tohoku-tomailab/saigen/README.md

# SAIGEN

**SAIGEN** — **S**tandardized **A**utomation **I**nfrastructure for **G**eneralizable
**E**xperiment reproductio**N** (also *saigen*, 再現, Japanese for "reproduction").

A simple, easy-to-introduce, open-source platform for automated materials-synthesis
experiments, focusing on **reliable automation and quantitative process recording**
rather than full autonomy.

Repository: https://github.com/tohoku-tomailab/saigen
(QR code for slides and posters: [`docs/images/qr-saigen.png`](docs/images/qr-saigen.png),
[`docs/images/qr-saigen.svg`](docs/images/qr-saigen.svg))

A paper describing the platform and its ZIF-8 demonstration has been accepted for
publication in *Science and Technology of Advanced Materials: Methods* (STAM Methods)
and is in press (working title: *Quantitative control and improved reproducibility of
materials synthesis processes using an automated experimentation platform*). It is
referred to as "the paper" throughout this repository; see [Citing](#citing).
<!-- TODO: on publication, replace the working title with the published one and add
     the volume and article number, here, under "Citing" and in CITATION.cff. -->

The platform combines commercially available instruments (robot arms, electric
pipettes, web cameras, an electronic balance) with 3D-printed fixtures, and operates
them with control code generated by an AI agent based on a large language model (LLM).
As a demonstration, ZIF-8 (a metal–organic framework) was synthesized with a
two-solution mixing system, and the dependence of its particle size distribution on
the solution dispensing speed was quantified and reproduced.

**Video:** the two-solution mixing system built on this platform, in operation:
https://youtu.be/5X2-4LuQfns

## Repository layout

The repository's main resources are organized into five parts:

| Part | Folder |
|---|---|
| Control code for the instruments | [`src/`](src/) |
| Fixture design data (CAD design bank) | [`cad/`](cad/) |
| Procedures for setting up and modifying the system | [`docs/`](docs/) |
| Knowledge base: what bringing each instrument into the cell taught us | [`knowledge/`](knowledge/) |
| Example experiments | [`examples/`](examples/) |

Beside these, `tests/` and `.github/` hold the automated tests and their CI, and
`detection/` is an optional object-detection module kept apart for licensing
reasons (see below). In detail:

| Path | Contents |
|---|---|
| `src/agent/` | AI agent that generates JSON experimental flows from natural language (Gemini API or any OpenAI-compatible endpoint) and the preset flows |
| `src/devices/` | Control drivers for each instrument (robot arm, electric pipette, hot-plate stirrer, electronic balance, webcam, digital microscope, and the optional Hiwonder MaxArm suction arm) and the safety wrapper the flows run through |
| `src/flow/` | Schema, validator, executor and command-line runner for the JSON experimental flow format |
| `src/gui/` | Browser-based GUI for parameter input and flow confirmation |
| `src/voice/` | Voice input (whisper-large-v3-turbo) |
| `src/monitoring/` | IoT sensor logging (Raspberry Pi + Environment Sensor HAT) and process cameras |
| `src/imaging/` | Appearance-imaging system: NEEWER RGB62 light + Logitech C920n camera control, white/red/green/blue capture sequence, cropped-image comparison and depth-direction transmitted-light profiles (paper Figure 6) |
| `detection/` | Object detection based on YOLOv8 — **kept separate for licensing reasons, see below** |
| `cad/` | CAD design bank of 3D-printable experimental components (STL + editable Fusion 360 sources) |
| `docs/` | Procedures: bill of materials, setup guide, experimental-flow format reference, spreadsheet-input guide, guide to adding an instrument |
| `knowledge/` | Knowledge base: what bringing each instrument into the cell taught us (order of work, replies that differed from the manual, defects found, open points). Index in [`knowledge/README.md`](knowledge/README.md) |
| `examples/zif8/` | Sample experimental flows of the ZIF-8 demonstration (JSON equivalents of the spreadsheet sequence) and monitoring CSV templates |
| `examples/microscope/` | Example flow that photographs the product with the USB digital microscope (`capture_microscope`) |
| `examples/maxarm/` | Example suction pick-and-place flow for the optional Hiwonder MaxArm (robot 4) |
| `examples/mg400/` | Example flow and complete `config.yaml` for the optional Dobot MG400 (robot 5, TCP/IP) |
| `examples/dispensing_stability/` | Measured data of the 100-shot dispensing-repeatability test and the script that recorded it |

## Getting started

1. See [`docs/bom.md`](docs/bom.md) for the full list of hardware used.
2. Print the fixtures in `cad/` (STL files; the Fusion 360 sources are included for
   modification — see [`cad/README.md`](cad/README.md)).
3. Follow [`docs/setup.md`](docs/setup.md) to connect the instruments to the control PC.
4. Copy `config.example.yaml` to `config.yaml` and set the COM ports and workspace
   limits of your own cell; copy `.env.example` to `.env` and set your API keys.
   **Never commit `.env` or `config.yaml`.**
5. Install the Python dependencies: `pip install -r requirements.txt`
   (module-specific notes, e.g. for the imaging system, are in each `src/<module>/README.md`).
   Check the installation with `pytest tests/` — the suite needs no hardware.
6. After every power-on, home each arm once so the firmware's joint angles match the
   real arm (`python -m src.devices.dobot.home_dobot --robot 1 --mock` to rehearse,
   then without `--mock`; the arm sweeps to its joint-1 end stop, so clear the area).
   Then dry-run a flow without hardware, then run it for real. The ZIF-8 examples are the
   JSON equivalents of the spreadsheet sequence in step 7, which is the path the
   paper's batches were actually run with:

   ```bash
   python -m src.flow.run_flow examples/zif8/zif8_two_solution_mixing_speed5.json --mock
   python -m src.flow.run_flow examples/zif8/zif8_two_solution_mixing_speed5.json
   ```

   Every move is checked against the `workspace` limits in `config.yaml` before the
   robot is commanded — in `--mock` mode too. Ctrl+C is an emergency stop: the arm
   halts where it is rather than driving home (an MG400 is the exception: its Ctrl+C
   starts an orderly stop, a second Ctrl+C waits for it to finish, and its emergency
   stop is the button on its controller,
   `docs/setup.md` §13). Each run leaves
   `logs/<date>/<flow>_<time>/` with `run.log`, `measurements.csv`, `summary.md`,
   `metadata.json` and a copy of the flow; add `--no-record` to skip the sensor-CSV
   and video recording that real runs start by default.

7. Or set the parameters in a spreadsheet — **this is the path used for the paper's
   ZIF-8 experiments**: the two-solution mixing experiment (shown in the
   [video](https://youtu.be/5X2-4LuQfns) above) runs from a
   `parameter,value,note` CSV, with no JSON at all:

   ```bash
   cp src/flow/csv_runner/control.example.csv src/flow/csv_runner/control.csv
   python -m src.flow.csv_runner.run_csv --mock   # then without --mock for a real run
   ```

   The sheet is range-checked before any device is opened, the generated steps go
   through the same schema and workspace validator as a JSON flow, and the run leaves
   the same log folder; see [`docs/csv-runner.md`](docs/csv-runner.md).

8. Or use the GUI, where flows can also be generated from natural language or voice
   (the reported ZIF-8 batches did not use this path):

   ```bash
   streamlit run src/gui/app.py
   ```

   Ports come from `config.yaml` and stay editable in the sidebar; the flow is
   validated against the same schema before any device is opened, *Mock* runs it
   end to end without hardware, *Stop* aborts through the same emergency-stop path
   as Ctrl+C, and the run leaves the same `logs/<date>/…` folder as the CLI.

## Using SAIGEN with an AI coding agent

The intended way to adopt SAIGEN is to clone (or download) the repository, open it
in an AI coding agent such as Claude Code, Codex or Cursor, and let the agent adapt
it to your hardware in conversation. [`CLAUDE.md`](CLAUDE.md) (identical to
[`AGENTS.md`](AGENTS.md)) tells the agent how the repository is organised, how to
verify changes without hardware, and what it must not do on its own — in particular,
it must never start a real run or loosen the workspace limits without you asking.
A first message that works well:

> Read CLAUDE.md, then help me adapt this platform to my hardware: one Dobot Magician
> on COM3 with a Picus 2 pipette on COM4, a BCE8221 balance on COM8 and no second robot.
> Validate and mock-run an example flow when you are done.

Everything the agent does is also available by hand through the steps above.

The flow format is described in [`docs/experimental-flow.md`](docs/experimental-flow.md),
the spreadsheet input in [`docs/csv-runner.md`](docs/csv-runner.md), and adding an
instrument to the platform in [`docs/adding-an-instrument.md`](docs/adding-an-instrument.md); the ZIF-8 flows —
JSON equivalents of the spreadsheet sequence the paper's batches were run with — are in
[`examples/zif8/`](examples/zif8/).

## Licensing

- **Code** (`src/`, `examples/`): MIT License — see [`LICENSE`](LICENSE). Third-party components are listed in [`THIRD_PARTY_NOTICES.md`](THIRD_PARTY_NOTICES.md).
  The robot-arm driver uses [pydobot](https://github.com/luismesas/pydobot)
  (Copyright 2017 Luis Mesas, MIT License) with a small patch in
  `src/devices/dobot/pydobot_patch.py`. The vendor SDK (DobotDll) is **not** used and
  is not included in this repository.
- **CAD models and documentation** (`cad/`, `docs/`, `knowledge/`): Creative Commons Attribution 4.0
  (CC BY 4.0, https://creativecommons.org/licenses/by/4.0/); the CAD-specific notes are in
  [`cad/README.md`](cad/README.md).
- **Object detection** (`detection/`): depends on [Ultralytics YOLOv8](https://github.com/ultralytics/ultralytics),
  which is licensed under **AGPL-3.0**. This module is therefore isolated from the
  MIT-licensed code and is distributed under AGPL-3.0. The rest of the platform runs
  without it (object detection is an optional monitoring feature).

The fine-tuned YOLOv8 weights and the training images are **not** included in this
repository. `detection/README.md` describes how to fine-tune your own model for your
setup.

## Disclaimer

SAIGEN is research software, shared so that others can reproduce and build on our
work. It is provided "as is", without warranty of any kind; the full terms are in
[`LICENSE`](LICENSE) for the code and in Section 5 of CC BY 4.0 for the CAD models and
documentation. The authors and their institutions accept no liability for injury,
damage to equipment, loss of samples or data, or any other loss arising from its use.

- **It moves hardware and handles chemicals.** A real run drives robot arms, dispenses
  liquids and may heat and stir them. Anyone running it is responsible for their own
  risk assessment, for following the safety rules of their institution and the safety
  data sheets of their reagents, and for supervising the cell while it operates.
- **The safety layer is not a certified safety system.** The workspace validators and
  the emergency stop reduce the chance of a collision inside the limits *you*
  configure. They are not a substitute for guarding, a hardware emergency stop or
  the manufacturers' instructions, and they know nothing about what is actually on
  the bench. Measure your own cell, set your own limits, and always do a mock run
  and a supervised dry run before using reagents.
- **Review generated flows and code.** Flows drafted by the LLM agent, and changes
  made by an AI coding agent, can be wrong in ways that validation does not catch
  (a wrong volume, vial or temperature is still a valid flow). Read them before a
  real run.
- **The CAD models are untested outside our laboratory.** They were designed for our
  instruments and printers; strength, fit, heat resistance and chemical resistance
  depend on your material and print settings and are not guaranteed.
- **No affiliation.** SAIGEN is not affiliated with, endorsed by or supported by the
  manufacturers of the instruments it controls. Product names are trademarks of their
  respective owners. Using this software may fall outside an instrument's intended use
  and may affect its warranty; check with the manufacturer.

## Citing

If you use SAIGEN, please cite the paper:

> Y. Hashimoto, T. Muramoto, H. Terada, H. Song, Y. Wang, T. Tomai,
> *Science and Technology of Advanced Materials: Methods*, in press (2026).
> https://doi.org/10.1080/27660400.2026.2756911

The DOI becomes active when the paper is published. The software itself can be cited
with the metadata in [`CITATION.cff`](CITATION.cff) (GitHub's "Cite this repository"
button, which offers the paper as the preferred citation).
