tohoku-tomailab/saigen/docs/images/qr-saigen.png

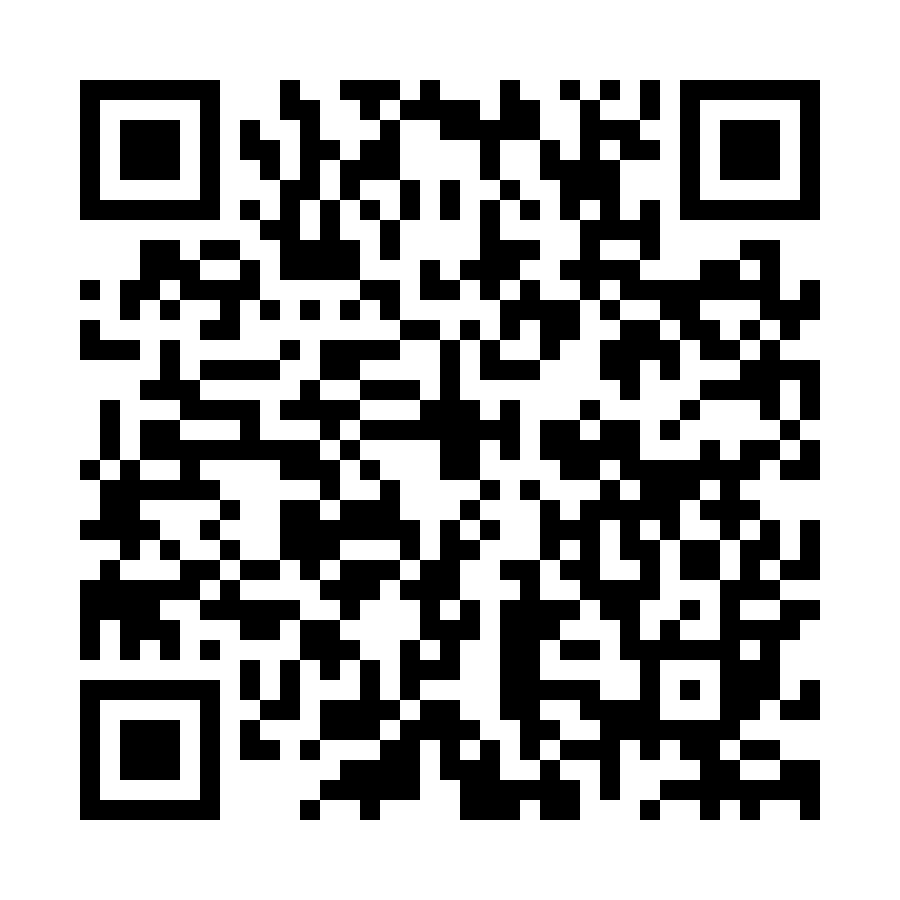
docs/images/qr-saigen.png
