tohoku-tomailab/saigen/cad/pipette-holder/picus2/picus2_holder_tall.step

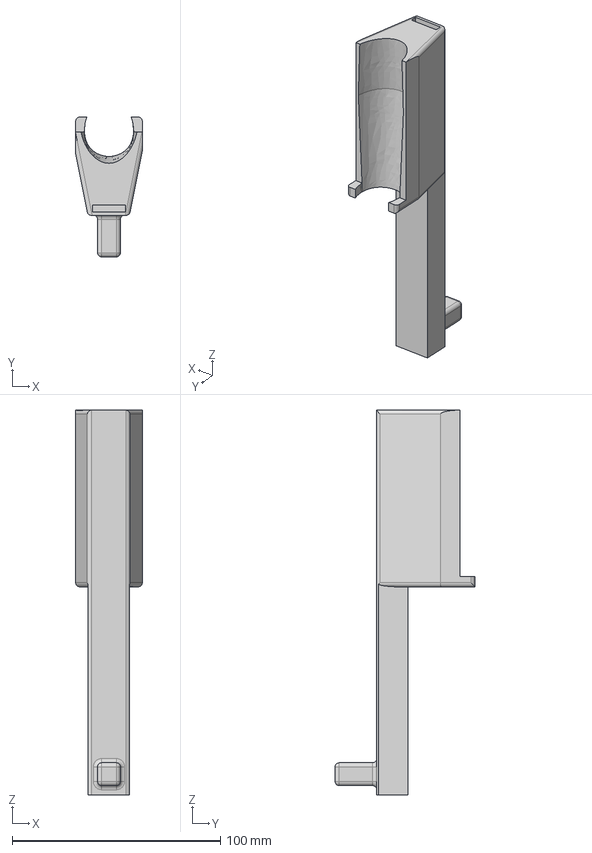
[picture p6: CAD file, 2026-11-02]
cad/pipette-holder/picus2/picus2_holder_tall.step
32.0 x 67.2 x 185.0 mm
