tohoku-tomailab/saigen/cad/pipette-holder/picus2/picus2_holder_short.step

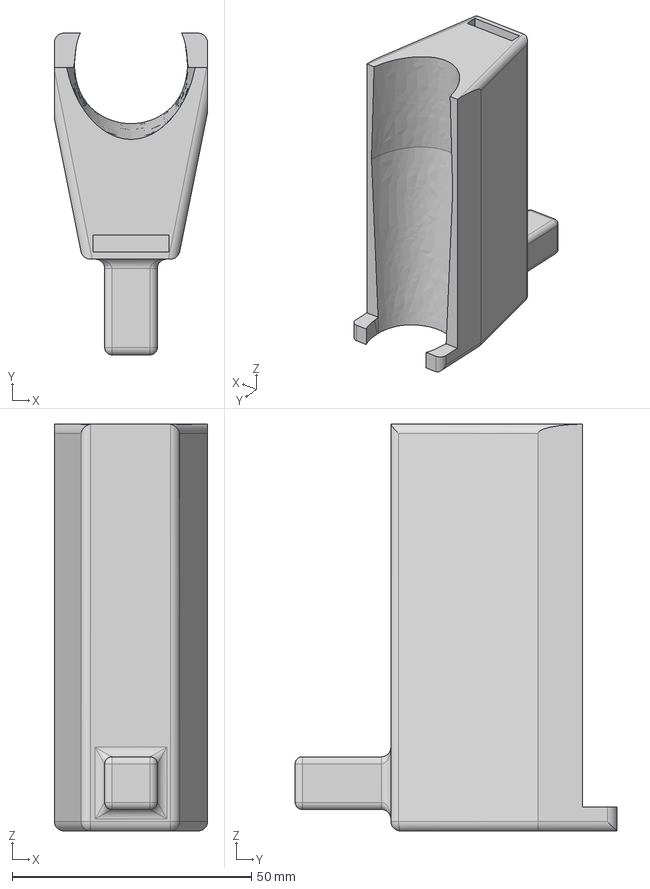
[picture p7: CAD file, 2026-11-02]
cad/pipette-holder/picus2/picus2_holder_short.step
32.0 x 67.2 x 85.0 mm
