tohoku-tomailab/saigen/cad/pipette-holder/picus2/picus2_holder_middle.step

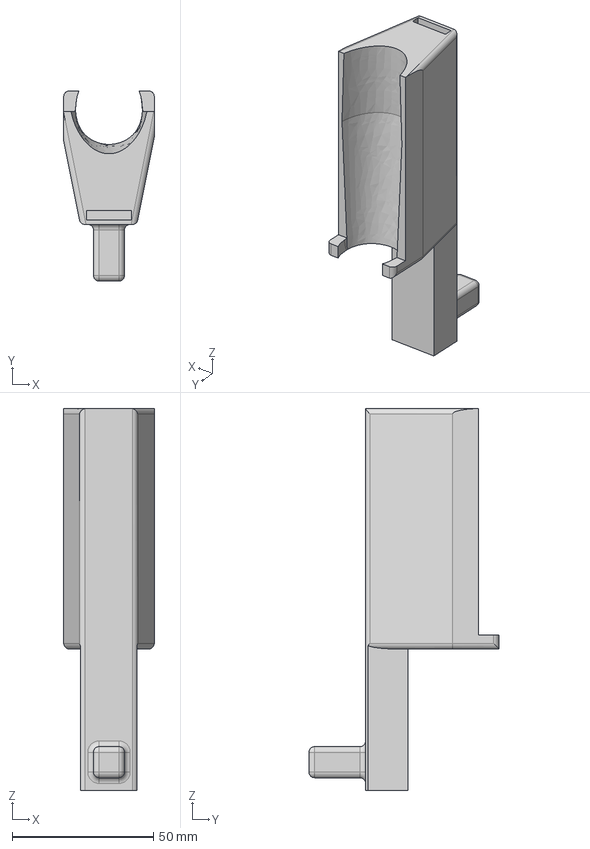
[picture p8: CAD file, 2026-11-02]
cad/pipette-holder/picus2/picus2_holder_middle.step
32.0 x 67.2 x 135.0 mm
