tohoku-tomailab/saigen/cad/pipette-holder/picus2/picus2_holder_3_middle.step

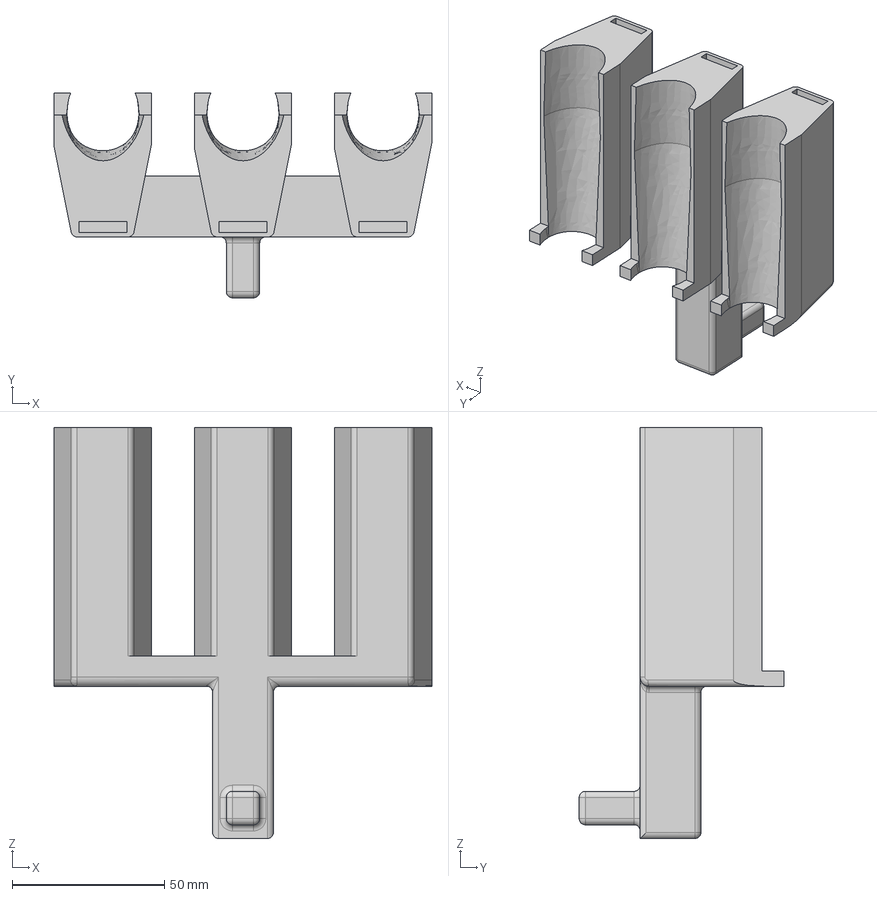
[picture p9: CAD file, 2026-11-02]
cad/pipette-holder/picus2/picus2_holder_3_middle.step
124.0 x 67.2 x 135.0 mm
