tohoku-tomailab/saigen/(list of files, cad)

Other CAD files:
cad/pipette-holder/picus2/picus2_holder_3_middle.f3d
cad/pipette-holder/picus2/picus2_holder_3_middle.stl
cad/pipette-holder/picus2/picus2_holder_middle.f3d
cad/pipette-holder/picus2/picus2_holder_middle.stl
cad/pipette-holder/picus2/picus2_holder_short.f3d
cad/pipette-holder/picus2/picus2_holder_short.stl
cad/pipette-holder/picus2/picus2_holder_tall.f3d
cad/pipette-holder/picus2/picus2_holder_tall.stl
