tohoku-tomailab/saigen/docs/experimental-flow.md

# Experimental flow format

The AI agent outputs experimental procedures as a JSON "experimental flow" — an
intermediate representation connecting the natural-language experimental objective
with the control code actually executed. Constraining the LLM output to structured
JSON suppresses generation variability and enables mechanical validation before
execution.

The schema is defined with Pydantic in [`src/flow/schema.py`](../src/flow/schema.py)
and executed by [`src/flow/executor.py`](../src/flow/executor.py). Run
`python src/flow/schema.py` to print the machine-readable JSON Schema.

## Top level

```json
{
  "name": "human-readable name",
  "description": "what the flow does",
  "steps": [ { "action": "...", ... }, ... ]
}
```

| Field | Type | Required | Notes |
|---|---|---|---|
| `name` | string | yes | |
| `description` | string | no | default `""` |
| `steps` | array | yes | executed in order; each element is one of the actions below |

Every step has an `action` field. Robot actions take `robot_id` (1–5, default 1);
shared-device actions (balance, camera) do not. Unknown fields (e.g. a misspelled
`robotid`), out-of-range values and non-finite numbers (`NaN`, `Infinity`) are
rejected at validation time.

### Robot types

Each robot in `config.yaml` has a `type`. Robots 1–3 are Dobot Magicians
(`type: dobot`, the default when the entry has no `type`, so existing
`config.yaml` files keep working). Robot 4 is an optional Hiwonder MaxArm
(`type: maxarm`) with a suction nozzle and no pipette. Robot 5 is an optional
Dobot MG400 (`type: mg400`) over TCP/IP, with neither. The type decides which
robot actions a robot accepts:

| Type | Accepted robot actions |
|---|---|
| `dobot` | `move_xyz`, `move_z`, `move_radial`, `rotate`, `rotate_relative`, `go_home`, `move_slider`, `move_conveyer`, `wait`, `aspirate`, `dispense`, `blow_out` |
| `maxarm` | `move_xyz`, `move_z`, `go_home`, `suction`, `wait` |
| `mg400` | `move_xyz`, `move_z`, `go_home`, `wait` |

The preflight rejects an action the robot's type does not accept (for example
`aspirate` on the MaxArm, or `suction` on a Dobot) before any device is opened,
exactly like a workspace violation (exit code 3 / `PreflightError`). The
executor refuses the same actions at run time as a second line of defence.

A robot can have its own `workspace` block under `robots.<id>` in
`config.yaml`. For a Dobot it is merged over the global `workspace` for that
robot only. A MaxArm (`type: maxarm`, at any robot id) or an MG400 (`type:
mg400`) **must** have one, and it is used on its own, never merged over the
global Dobot box (the frames differ):
`x_min` … `z_max` are all required, `r_min` / `r_max` (bounds on the horizontal
radius `hypot(x, y)`) are optional. A missing or incomplete MaxArm block, or any
workspace key left without a value (null), stops `--validate-only`, `--mock` and
real runs with a configuration error naming the robot, before any device is
opened. For the MaxArm the validator additionally runs the arm's own inverse
kinematics on the PC (`src/devices/maxarm/kinematics.py`): a `move_xyz` target
inside the box can still be unreachable (the wrist joint would leave 0..240°,
which happens near the top of the workspace), and such a step is rejected at
`--validate-only` with the highest reachable z at that (x, y). See
`docs/setup.md` §9. An MG400 entry must also set `home_position`,
`joint_limits`, `speed_ratio` and `max_move_mm` (nothing is inherited); its
`home_position` is checked against its box at `--validate-only`, and each move
is checked at run time against the box, the segment's radius and the
controller's inverse kinematics (`docs/setup.md` §13).

## Actions

### Robot arm (Dobot Magician) — `robot_id` required

| `action` | Parameters | Description |
|---|---|---|
| `move_xyz` | `x`, `y`, `z` (mm) | Absolute move in the arm's Cartesian frame |
| `move_z` | `distance` (mm) | Relative vertical move; positive = up |
| `move_radial` | `distance` (mm) | Relative move along the radius from the base; positive = outward |
| `rotate` | `angle` (deg) | Absolute base (joint 1) rotation |
| `rotate_relative` | `angle` (deg), `speed` (`"low"`/`"normal"`/`"high"`, default `"low"`) | Relative base rotation; positive = counter-clockwise seen from above (toward +Y) |
| `go_home` | — | Return to the home position captured at start-up |
| `move_slider` | `position` (0–1000 mm) | Linear rail (optional accessory) |
| `move_conveyer` | `index` (0/1), `speed` (0–200 mm/s), `duration` (0–300 s) | Conveyor belt (optional accessory) |

### Electric pipette (Sartorius Picus 2) — `robot_id` required

| `action` | Parameters | Description |
|---|---|---|
| `aspirate` | `volume` (0.5 ≤ v ≤ 10 mL), `speed` (1–9, default 5) | Aspirate; the wrapper refuses to exceed 10 mL total |
| `dispense` | `volume` (0.5 ≤ v ≤ 10 mL), `speed` (1–9, default 5) | Dispense; refuses to exceed the held volume |
| `blow_out` | `go_home` (bool, default true), `speed` (1–9, default 1), `delay_ms` (int, default 3000) | Expel residual liquid |

Speed 1 is slowest, 9 fastest (about 1–11 mL/s for a 10 mL tip, from the manufacturer's timing table).
The lower bound of 0.5 mL is the real wrapper's minimum operating volume
(`LabRobot.min_pipette_volume`); the schema enforces it so that a flow the mock
accepts is not rejected on hardware.

### Suction nozzle (Hiwonder MaxArm) — `robot_id` of a `maxarm` robot

| `action` | Parameters | Description |
|---|---|---|
| `suction` | `on` (bool, default true) | `true` switches the pump on (the object is held); `false` releases it (the firmware opens the release valve for about 1 s, so wait before lifting). Only a robot with `type: maxarm` accepts it |

MaxArm coordinates are in the arm's own frame (mm, origin on the base yaw axis,
z = 0 at the base plane, the arm faces −y at home); `move_xyz` / `move_z` /
`go_home` behave as on the Dobot. After an error the session stops the MaxArm
where it is and does **not** send it home (it has no verified safe return path);
the Dobots are still sent home as before. See
[`examples/maxarm/pick_and_place.json`](../examples/maxarm/pick_and_place.json).

### Dobot MG400 — `robot_id` of an `mg400` robot

An MG400 (`type: mg400`, robot 5 in the examples) accepts `move_xyz`, `move_z`,
`go_home` and `wait` only. Coordinates are the controller's base frame (mm, the
flange position as `PositiveSolution` reports it, User 0 / Tool 0); every move
keeps the R measured when the arm was connected. Every move is one straight `MovL` of at least
1 mm and at most `max_move_mm` (≤ 50 mm), checked before it is sent against
the robot's own box, the horizontal radius of the whole segment and the
controller's `InverseSolution` sampled every 5 mm within `joint_limits`
(`docs/setup.md` §13 lists the six steps). `go_home` goes to the configured
`home_position` and sends nothing when the arm is already within 1 mm of it.
After an error the session does not send an MG400 home; the stop sequence tries to
disable it where it stands, and the device report (`robot_reports`) says whether the
arm confirmed that. A real run asks the human for Enter on the terminal (or the GUI's
confirmation dialog) before any device is opened. The example is
[`examples/mg400/z_hop.json`](../examples/mg400/z_hop.json).

### Shared devices — no `robot_id`

| `action` | Parameters | Description |
|---|---|---|
| `tare_scale` | `delay` (0.1–10 s, default 1.0) | Tare the electronic balance |
| `measure_weight` | `stabilization_count` (1–10, default 3) | Read the balance; median of N readings, logged in grams |
| `capture_and_save` | `file_path` (string, `""` = auto-generate) | Capture a webcam image. If no image is saved the step fails (and the run stops) rather than being recorded as `ok`; the same holds for `capture_microscope` |
| `capture_microscope` | `file_path` (string, `""` = auto-generate) | Capture an image with the USB digital microscope (UVC, e.g. Sanwa Supply 400-CAM106); saved into the run's `images/` folder with `_microscope` in the name. Opens only the microscope camera; `microscope_led` opens only its serial port; `microscope_focus` opens both |
| `microscope_led` | `on` (bool, default true), `level` (0–255, optional) | Switch the microscope's LED ring on or off and optionally set its brightness (factory level 12). Needs `microscope_port` in `config.yaml` (the UM22's CP210x serial port) |
| `measure_dmm` | `function` (`dc_voltage`, `ac_voltage`, `dc_current`, `ac_current`, `resistance_2w`, `resistance_4w`; default `dc_voltage`), `samples` (1–10, default 3), `nplc` (0.01–50, default 1), `range` (optional fixed range in V, A or Ohm; omitted = autorange) | Measure with the Keithley 2002 DMM over GPIB; median of the valid samples (overflow readings are discarded). Writes `dmm_value` (full precision), `dmm_unit`, `dmm_function`, the `dmm_range` and `dmm_nplc` read back from the instrument after the last sample (on autorange: the range the last sample used) and `dmm_valid_samples` to `measurements.csv`. Each step starts from `:CONFigure:<function>` (single-shot trigger model; math, buffer and scanning off; acquisition method normal; autozero and the function's own settings such as filter and REL back to their `*RST` values), so those front-panel settings do not change the result. Settings outside that list, such as line synchronization, are left alone; the line-sync state is written to `run.log` when the DMM is opened. Needs `dmm_resource` in `config.yaml` (e.g. `GPIB0::16::INSTR`). A flow of DMM steps only opens no robot |
| `measure_lockin` | `samples` (1–100, default 5), `interval` (0–60 s between readings, default 0) | Read the NF LI5640 lock-in amplifier over GPIB (read-only: its measurement settings stay on the front panel; only the read-out selection `OTYP` is written and restored). Median of the valid readings of DATA1 and DATA2 (as displayed: X, R, θ, noise or AUX; θ on the narrowest arc, the step fails if the phases spread over 180° or more) and of the measured reference frequency. Readings with an over-level or UNLOCK are discarded and counted. Writes `lockin_data1` / `lockin_data2` (full precision) with `_kind` (e.g. `X`, `THETA`, `X[dB]`, `Y[ratio]`) and `_unit`, `lockin_freq`, `lockin_sensitivity`, `lockin_time_constant`, `lockin_valid_samples`, `lockin_invalid` and the panel settings (`lockin_settings`, JSON) to `measurements.csv`. The step fails if a panel setting differs before and after the readings; the settings and the difference then go to the `diagnostics` column and `metadata.json`. It does not wait for the output to settle. Needs `lockin_resource` in `config.yaml`. A flow of lock-in steps only opens no robot |
| `measure_scope` | `channel` (1–4, default 1; 1–2 on two-channel models), `items` (1–10 distinct of `vpp`, `vmax`, `vmin`, `vamplitude`, `vtop`, `vbase`, `vaverage`, `vrms`, `frequency`, `period`, `risetime`, `falltime`, `pwidth`, `nwidth`, `pdutycycle`, `ndutycycle`, `overshoot`, `preshoot`; default `["vpp", "frequency"]`), `samples` (1–20, default 3), `interval` (0–60 s, default 0.5) | Read automatic measurements from an Agilent 1000 series oscilloscope over USB (read-only: queries only, plus a device clear on open and close and `*CLS` on open; the set-up stays on the front panel). Per item, the median of the valid reads (bounds such as `<2e-9`, unparsable, non-finite and 9.9e37 replies are discarded and counted). Writes `scope_channel` and, as JSON keyed by item, `scope_values`, `scope_units` (V / A / W from the channel units, Hz, s, %), `scope_valid`, `scope_invalid`, plus the settings (`scope_settings`) to `measurements.csv`; the raw replies go to `metadata.json`. Fails on an X-Y or zoomed time base, a non-edge trigger, a hidden channel, a setting that differs before and after, an item without any valid read, or an instrument error. `samples` counts reads, not acquisitions. Needs `scope_resource` in `config.yaml`. A flow of oscilloscope steps only opens no robot |
| `microscope_focus` | `mode` (`auto` / `position` / `step`, default `auto`), `position` (0–65535, for `position`), `direction` (`in`/`out`) and `steps` (1–100, for `step`), `timeout` (1–300 s, default 60) | Focus the microscope: single-shot autofocus, move the lens motor to a recorded position, or step it. Waits until the motor stops and writes the lens position and whether it converged to the `focus_position` / `focus_converged` columns of `measurements.csv`. Autofocus needs a textured target and a non-saturating LED level; on a blank field it hunts until `timeout` and then falls back to manual mode. For reproducibility, record the position once and replay it with `mode: "position"`. Needs `microscope_port` |

### Utility and control flow

| `action` | Parameters | Description |
|---|---|---|
| `set_lockin_oscillator` | `frequency` (Hz, 0.0005–105000, representable at 4½ digits), `amplitude` (Vrms, 0–5, representable in the amplitude range set on the panel), `settle` (0–600 s, default 0) | Set the internal oscillator (OSC OUT) of the NF LI5640. **Disabled by default**: refused before anything opens unless `lockin_osc_max_vrms` in `config.yaml` is above 0 (also `lockin_osc_min_hz` / `lockin_osc_max_hz`); the limits bound the set values only. The amplitude range is never switched. Each command is read back and the error queue checked before the next; a failure stops the step and further oscillator writes in the run. `settle` is a wait after the read-back, not a settling guarantee. At the end of the run (also after a failure or Ctrl+C) the values found on connect are written back; the result is in `metadata.json` (`lockin_oscillator_restore`), and a restore that failed or could not be checked marks the run failed. Writes `lockin_osc_freq_hz`, `lockin_osc_ampl_vrms`, `lockin_osc_range`, `lockin_osc_settle_s`, `lockin_osc_settled_s` to `measurements.csv` |
| `wait` | `seconds` (≥ 0) | Sleep. When `robot_id` is omitted it is 1, so a flow with `wait` opens robot 1. For a pause after each `measure_dmm` step without opening a robot, use `wait_after_dmm` in `config.yaml` (it applies to DMM steps only); after each `measure_lockin` step, `wait_after_lockin`; after each `measure_scope` step, `wait_after_scope` |
| `loop_start` | `loop_id` (string), `count` (1–1000) | Begin a loop |
| `loop_end` | `loop_id` | End the loop with the same `loop_id` |

Loops are expanded into a flat list before execution (`expand_loops`). Nesting is not
supported; a `loop_start` without a matching `loop_end` (or vice versa), or a
`loop_end` with a different `loop_id` inside a loop body, is an error.

## Validation rules

Applied before any device moves:

1. **Schema** — every step must match exactly one action model; types and ranges
   above are enforced by Pydantic.
2. **Loop structure** — `loop_id`s must pair up and must not nest.
3. **Workspace and capability preflight** (`--validate-only` and before every
   run, no device opened) — every absolute target (`move_xyz`, `rotate`) is
   checked against the robot's workspace (for a Dobot, `robots.<id>.workspace`
   merged over the global `workspace` section of `config.yaml`, or the global
   section alone when the robot has none; for a MaxArm or an MG400, its own
   required `robots.<id>.workspace` alone, and for an MG400 also its
   `home_position`), and every robot action is checked against the
   robot's type (see *Robot types*). Relative moves (`move_z`,
   `rotate_relative`, `move_radial`) depend on the start pose and are listed as
   "unverified until run"; rule 5 checks them. The same preflight
   (`run_flow.run_preflight` / `require_preflight`) guards all three runners: the
   CLI (`run_flow.py`, exit code 3), the CSV runner (`run_csv.py`, exit code 3)
   and the GUI (`src/gui/runner.py`, which refuses to start the run and shows the
   offending steps and coordinates).
4. **Pipette volume tracking** (run time, in the safety wrapper) — cumulative
   `aspirate` may not exceed 10 mL; `dispense` may not exceed the volume held.
5. **Workspace limits** (run time, move by move) — `move_xyz` / `move_z` / `rotate*` targets are
   checked against the XYZ box and joint-1 range of the robot's workspace (as in
   rule 3); a violation raises before the command is sent, aborting the run.
   The same check runs in `--mock` mode, so a flow can be screened for out-of-range
   moves without hardware.

Conventions the agent's system prompt also enforces: Robot 3 (rail robot) carries
no pipette; each loop body and the whole flow end with `go_home`.

## Full example — ZIF-8 two-solution mixing

This is `examples/zif8/zif8_two_solution_mixing_speed5.json` (solution 2 dispensed at
pipette speed 5, nominal ≈1.45 s for 5 mL). The `speed1` and `speed9` variants differ
only in the `speed` of the second `dispense`.

The three files are the **JSON equivalents of the CSV-runner sequence** — the fixed
ten-step-per-robot sequence in [`docs/csv-runner.md`](csv-runner.md) that the paper's
ZIF-8 batches were actually run with — plus one closing `capture_and_save`, which the
CSV runs did not take. They are not the files that were executed for the paper; see
`examples/zif8/README.md`.

Running a flow leaves a record of the run in
`logs/<YYYY-MM-DD>/<flow name>_<timestamp>/`: `run.log`, `measurements.csv` (one row
per step, with the weights read, the nominal pipette duration of each aspirate/dispense
step from the Picus 2 timing table, and the photographs taken), `summary.md`,
`metadata.json`, `images/` and a copy of the flow JSON. `metadata.json` also
records the type of every robot used (`robot_types`, e.g. `{"4": "maxarm"}`)
and, for an MG400, its device report after the disconnect (`robot_reports`:
record folder, whether the run completed and the arm reported disabled, the
`stop` section when a stop sequence ran).
The execution mode
(`mock` / `real`) is recorded in `metadata.json` (`mode`), in a `mode` column of
`measurements.csv` and in `summary.md`. Runs started within the same second get
distinct folders (`_2`, `_3`, … suffix). When sensor recording is on, a run stops
only a dashboard recording it started itself (`/api/start` → 200); a recording that
was already running (409) is left running, and `metadata.json` →
`sensor_recording.started_by_this_run` says which. See
[`src/flow/README.md`](../src/flow/README.md).

```json
{
  "name": "ZIF-8 two-solution mixing (solution 2 dispensed at pipette speed 5)",
  "description": "… (see the file)",
  "steps": [
    {"action": "move_z", "robot_id": 1, "distance": -0.1},
    {"action": "aspirate", "robot_id": 1, "volume": 5.0, "speed": 1},
    {"action": "move_z", "robot_id": 1, "distance": 0.1},
    {"action": "rotate_relative", "robot_id": 1, "angle": 90.0, "speed": "low"},
    {"action": "move_z", "robot_id": 1, "distance": -120.0},
    {"action": "tare_scale", "delay": 1.0},
    {"action": "dispense", "robot_id": 1, "volume": 5.0, "speed": 9},
    {"action": "measure_weight", "stabilization_count": 3},
    {"action": "move_z", "robot_id": 1, "distance": 120.0},
    {"action": "go_home", "robot_id": 1},

    {"action": "move_z", "robot_id": 2, "distance": -0.1},
    {"action": "aspirate", "robot_id": 2, "volume": 5.0, "speed": 1},
    {"action": "move_z", "robot_id": 2, "distance": 0.1},
    {"action": "rotate_relative", "robot_id": 2, "angle": -90.0, "speed": "low"},
    {"action": "move_z", "robot_id": 2, "distance": -120.0},
    {"action": "tare_scale", "delay": 1.0},
    {"action": "dispense", "robot_id": 2, "volume": 5.0, "speed": 5},
    {"action": "measure_weight", "stabilization_count": 3},
    {"action": "move_z", "robot_id": 2, "distance": 120.0},
    {"action": "go_home", "robot_id": 2},

    {"action": "capture_and_save", "file_path": ""}
  ]
}
```

Note the order inside each robot's block: the balance is tared only after the tip is
down in the vial, the mass is read before the tip rises again, and `go_home` — not a
second `rotate_relative` — brings the arm back.

Distances and angles are specific to the fixture geometry; see
`examples/zif8/README.md` for how to adapt them.

## Presets

Flows that have been checked on hardware are stored as *presets* in
`src/agent/presets/*.json`. A preset wraps a flow in `{"label", "description",
"template"}` and is offered in the GUI; the agent can also be asked to change only
the parameters of a preset (the step order is kept), which is the recommended way to
derive a new condition from a validated procedure.
