tohoku-tomailab/saigen/(commit log)

2026-10-01 maxarm: serial client, line protocol, MicroPython firmware, installer and teach tool
    New package src/devices/maxarm/ for the Hiwonder MaxArm (ESP32, bus servos,
    suction nozzle), first of three commits that add it as optional robot 4.
    - protocol.py: ASCII line protocol "saigen-maxarm" proto 1 with XOR checksum,
    sequence numbers, OK/ERR replies and EVT events; byte-identical framing on
    both sides.
    - client.py: MaxArmClient (no-reset open, handshake PING/INFO/LIMITS/WATCHDOG
    with echo verification, heartbeat thread, move with read-back check, STOP
    always allowed, reset/fault/link-fault latches, timing validation).
    - firmware/saigen_maxarm.py + main.py: command server replacing Hiwonder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
2026-10-01 safety: MaxArmRobot wrapper, IK-aware validator, radius limits, interruptible moves
    Second of three MaxArm commits: the safety layer the flows run through.
    - maxarm_robot.py: MaxArmRobot (ROBOT_TYPE "maxarm"; move_xyz, move_z,
    go_home, suction, wait). Validates every target before sending, STOPs once
    on any non-validation failure and marks the pose unknown, checks the
    emergency-stop generation around every blocking call, keeps suction after an
    emergency stop or abnormal end (pump_off_after_estop option, default False),
    clears the firmware's stop latch at initialize only when the arm is not
    moving, refuses a missing validator and a double initialize, and plans
    go_home as "lift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
2026-10-01 flows/GUI/docs: wire the MaxArm in as robot 4, suction action, per-robot preflight
    Third of three MaxArm commits: everything that lets a flow use the arm.
    - schema.py: MAX_ROBOT_ID 4, "suction" action; executor.py: suction branch and
    a per-robot SUPPORTED_ACTIONS guard; experiment_session.py: validator_for_robot
    (a MaxArm gets its own IK-aware validator from robots.<id>.workspace, never
    the shared Dobot box), robot factories by type, configured home_position
    kept and checked, go_home_all skips the MaxArm; run_flow.py: ROBOT_ACTIONS_BY_TYPE,
    --robot<N>-maxarm, preflight per robot (workspace + capabilities) that fills
    a partial validators map; experiment_logger.py records robot ty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
2026-10-16 keithley2002: GPIB DMM driver, measure_dmm action, GUI block; fix GUI _num editor
    - src/devices/keithley2002/: PyVISA driver (lazy import, :CONF-based
    configure, read-back, overflow handling, abort check before every SCPI
    I/O, GTL on release) and a human-run self-check.
    - SharedDevices / MockSharedDevices: use_dmm, measure_dmm with a per-call
    stop flag, lock-guarded close that never closes under an I/O in flight,
    failed close logged and kept for retry.
    - Flow schema, executor, run_flow (--dmm-resource, DMM_RESOURCE),
    run_csv, experiment session (cleanup of a half-initialised device,
    interruption stays an interruption), logger columns and summary table.
    - GUI: measure_dmm block; f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
2026-10-16 docs: Keithley 2002 setup, commissioning notes, rules for blocking instruments
    - docs/keithley2002-commissioning.md: order of work, what firmware A09
    accepted, manual facts behind the driver, open line-sync observation,
    interruption and clean-up rules from review. DC voltage only; accuracy
    not verified.
    - setup.md §10 and troubleshooting; adding-an-instrument.md: instruments
    whose I/O blocks, logger, tests, GUI; flow reference, BOM, device index;
    CLAUDE.md / AGENTS.md table rows.
    Claude-Session: https://claude.ai/code/session_01RPZiJY8hJyLWMy3qkgJ2qY
2026-10-16 li5640: read-only GPIB lock-in amplifier, measure_lockin, step diagnostics
    - src/devices/li5640/: PyVISA driver for the NF LI5640. Front-panel
    settings are never written; the only setting is the read-out selection
    OTYP, read on open and restored (after a device clear, with read-back)
    on close. Each step reads ~30 panel settings before and after the
    readings and fails if they differ; the meaning and unit of DATA1/DATA2
    follow the manual's display rules (NOISE forces AUX1 on DATA2,
    normalize on X/R, ratio over normalize). Over-level / UNLOCK readings
    are discarded and counted; the phase median is taken on the narrowest
    arc (order-independent, fails if spread over 180 degrees).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
2026-10-16 docs: LI5640 setup, commissioning notes, rules for read-only instruments
    - docs/li5640-commissioning.md: read-only scope, order of work, what
    firmware 1.60 answered, step durations, defects found by review before
    the bench (display rules, phase median, OTYP restore, two-instrument
    clean-up, failed-step diagnostics), open points (Y under normalize,
    displays not yet seen), things not to do. Readings on an unknown input
    are not listed.
    - setup.md §11 and troubleshooting; experimental-flow.md measure_lockin;
    adding-an-instrument.md: restoring a read-out setting, multi-instrument
    clean-up, ResourcePlan, diagnostics; BOM, device index, CLAUDE.md /
    AGENTS.md rows.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
2026-10-16 docs: translate the driver READMEs into English, fix inaccuracies found in review
    Translate the seven Japanese READMEs under src/devices/ (microscope, ika,
    picus2, li5640, dobot, scale, keithley2002) and drop the Japanese copy of the
    MaxArm reset warning. src/devices/README.md no longer says "in Japanese".
    A read-only Codex review of the diff against the drivers also surfaced
    pre-existing errors, fixed here: dobot recommended disconnect() instead of
    force_stop() on an unusual noise and documented get_current_position() as
    four values (it returns eight); the Picus 2 Bluetooth examples used the USB
    default and calculate_operation_time() was said to wait; the balance README
    had the wrong tare(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
2026-10-19 dso1000: read-only USB oscilloscope (Agilent 1000 series), measure_scope
    - src/devices/dso1000/: DSO1002A/1004A/1012A/1014A/1022A/1024A over USB
    (PyVISA). Queries only, apart from a device clear on open and close and
    *CLS on open; the set-up stays on the front panel. 18 automatic
    measurement items; replies starting with < or >, unparsable, non-finite
    or >= 9.9e37 are discarded and counted per reason. No GTL: over USB it
    hung for 120 s and then failed on a DSO1014A (firmware 00.04.04).
    - SharedDevices.measure_scope: settings snapshot before and after the
    reads (ranges from the programmer's guide, exact units table); fails on
    X-Y or DELAYED time base, non-edge trigger, hidden cha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
2026-10-19 docs: DSO1000 setup, commissioning notes
    - docs/dso1000-commissioning.md: read-only scope, order of work, what
    firmware 00.04.04 answered (ENABLE for :KEY:LOCK?, 9.9E+37 from
    :MEASure, :MEASure:SOURce unchanged by sourced queries), defects found on
    the bench (GTL hang over USB, a front-panel lock of unknown cause) and by
    review, open points (no real signal was seen; % and < forms unverified),
    things not to do.
    - setup.md §12 and troubleshooting; experimental-flow.md measure_scope;
    adding-an-instrument.md; BOM, device index, CLAUDE.md / AGENTS.md rows.
    Claude-Session: https://claude.ai/code/session_01RPZiJY8hJyLWMy3qkgJ2qY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
2026-10-19 dso1000: English README, readings of a real signal on the bench
    - src/devices/dso1000/README.md translated into English, like the other
    driver READMEs.
    - A signal on CH1 of the DSO1014A (firmware 00.04.04): all 18 items were
    read; duty cycle, overshoot and preshoot came back without the trailing
    % the programmer's guide shows (the parser accepts both), no < / > reply
    was seen, :TRIGger:STATus? answered T'D, and the example flow ran end
    to end with --no-record. The signal was not a known reference, so
    accuracy remains unchecked. Commissioning notes and setup.md updated;
    a test pins the replies seen.
    Claude-Session: https:/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
2026-10-19 li5640: set_lockin_oscillator, internal oscillator writes off by default
    A flow step can set the frequency and OSC OUT amplitude of the LI5640's
    internal oscillator. It is refused before any device opens unless
    config.yaml sets lockin_osc_max_vrms above 0 (with lockin_osc_min_hz /
    lockin_osc_max_hz); the amplitude range is never switched, and values that
    would need rounding are never sent.
    Each command is read back and the error queue checked before the next; a
    failure stops further writes in the run. At the end of the run (also after a
    failure or Ctrl+C) the values found on connect are written back once; a
    restore that fails or cannot be checked, or a failed close, marks the run
    failed. A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
2026-10-19 docs: LI5640 internal oscillator, bench test of the sweep
    Driver README section on set_lockin_oscillator and its rules, setup.md
    section 11, flow reference row, example README, CLAUDE.md / AGENTS.md
    (the limits are not raised by an agent), and the commissioning notes of the
    oscillator sweep read on a DSO1014A (two completed runs, restore verified,
    one run stopped by the oscilloscope's V/div).
2026-10-20 docs: rules for instruments that write an output, DSO checked on a known signal
    adding-an-instrument.md gets "Instruments that write an output" (off by
    default, preflight limits, no rounding, no range switch, read-back per
    command, restore once, the result decides the run, one handle per
    instrument), each rule tied to a defect review found in the LI5640
    oscillator work. The DSO1000 notes answer the "known reference" open point
    with the LI5640 sweep and add the small-signal limit of the automatic
    frequency; the LI5640 notes separate the computed from the read Vpp.
    Device README and BOM mention the oscillator exception.
2026-10-20 mg400: observation-only tool over TCP/IP (no robot type yet)
    python -m src.devices.mg400.observe records what a later MG400 integration
    needs without changing the arm's state: it sends only six read-only
    Dashboard commands (RobotMode, GetErrorID, GetPose, GetAngle and the
    compute-only PositiveSolution / InverseSolution), each built in its exact
    form and re-checked before it is written, reads the feedback port and never
    opens the motion port. It ends, sending nothing more, on any mode other than
    disabled, an alarm, a stale or faulty feed, or a protocol error, and records
    every command (sent or not), the raw feedback packets and the controller's
    kinematics. Fake controller on loopback for --mo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
2026-10-20 docs: MG400 observation tool in the agent guide and the device list
    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
2026-10-20 devices: tidy the documentation, pin pytest's collection, fix the sign in Ek610i
    Documentation only, no module is renamed or moved (CLAUDE.md rule 3):
    - src/devices/webcam/README.md: new (configuration, API, human-run check)
    - src/devices/scale/README.md: the three balance modules and their roles;
    SerialBalance (the balance the flows use) was not described at all
    - src/devices/README.md: scale row, "each driver directory has a README",
    built-in COM ports are placeholders, powder dispenser fails in
    initialize() with RuntimeError (not ImportError), drivers know nothing
    about flows (not "experiments": the IKA driver keeps an older helper)
    - docs/setup.md: the balance self-check is A&D o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
2026-10-20 devices README: group the driver table by purpose, add a "Used from" column
    No file is moved or renamed. The one table becomes five, under Robot arms /
    Liquid handling / Heating and stirring / Measurement instruments / Cameras
    and microscopy, and each row gains a "Used from" column: flow, library only
    or observation only; the flow actions; the config.yaml keys; the safety
    wrapper class; an example flow. Every action and key named in the table
    was checked against src/flow/schema.py, src/flow/executor.py and
    config.example.yaml.
2026-10-21 mg400: fixes after the first bench run of the observation tool
    - GetPose(User=0,Tool=0) is no longer sent or allowed: the bench controller
    refused it with ErrorID -30001. The pose comparison uses GetPose() and
    records the frame indices of the feedback packet used.
    - Saving the record: report.json.tmp is fsynced, a refused rename is retried
    for about 1.5 s, and a save that still fails ends the run with
    MG400RecordError (exit 1). The error carries the recorder, so the message
    says what is on disk after the last save. A save failure on an error path
    never replaces the original exception, and a command is never sent unless
    its entry is on disk.
    - Connection errors (refused, no repl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
2026-10-21 mg400: continue on the second Dashboard connection when the first is dropped
    On the second bench run the controller closed the first Dashboard connection
    right after a second one was opened. The two-connection step now runs as
    control (idle wait, RobotMode on the first), open the second, settle, probe.
    Only a probe that meets a clean end of stream with no reply bytes, or a reset
    on send/recv of that probe, on dashboard-1, with no failed save, is tolerated:
    the record of it is saved, the first connection closed and the state checked
    on the second before the remaining read-only queries. Anything else ends the
    observation as before.
    Every connection is recorded with its open time and the time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
2026-10-21 mg400: send the six-parameter InverseSolution after the bench refused the joint-near form
    On the third bench run the controller answered the guide's
    InverseSolution(x,y,z,r,0,0,1,{j1,j2,j3,j4}) with -20000 (parameter number
    error). The builder and the exact-form allowlist now admit only
    InverseSolution(x,y,z,r,0,0), whose solution is the one nearest the arm's
    current joints; the record says so in kinematics_note. No fallback: an error
    reply still ends the run. The fake answers the joint-near form with -20000;
    that it answers the six-parameter form is its assumption.
    Claude-Session: https://claude.ai/code/session_01RPZiJY8hJyLWMy3qkgJ2q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
2026-10-22 docs: MG400 fourth bench run, the first complete observation record
    The six-parameter InverseSolution was answered on all 13 pairs (inverse of
    the forward solution within 0.000015 deg of the pair's joints); the first
    Dashboard connection's end was detected a third time after the second was
    opened; 1484 feedback packets over 12.1 s, none rejected; the joint values
    and the speed fields of the disabled arm are described as recorded. Open
    points updated: the next stage needs its own reviewed plan.
    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
2026-10-23 monitoring: add SENSOR_AGENT_TEMP_OFFSET_C to the Pi sensor agent
    The BME280 on the Environment Sensor HAT reads high because of self-heating.
    Add an optional offset (env SENSOR_AGENT_TEMP_OFFSET_C or --temp-offset,
    default 0.0) that is added to the temperature before it is sent, so a
    calibrated correction can be applied per Pi without touching the code.
    Documented in sensor-agent.env.example and the monitoring README.
    Claude-Session: https://claude.ai/code/session_01XXRRxHKX42KompacJYNYSB
2026-10-23 Revert "monitoring: add SENSOR_AGENT_TEMP_OFFSET_C to the Pi sensor agent"
    This reverts commit 273de4454b962c43a8d97402c3811f87ca886d5a, which was
    pushed to the public repository by mistake.
    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
2026-10-23 mg400: jog tool, the first command that changes the arm's state
    A human-run tool that enables the MG400, moves J1 and / or J4 by 1..10 deg
    with one JointMovJ and back, and disables it, with a stop sequence and a
    record. Reviewed by Astra over sixteen rounds (plan revisions 1 to 16);
    nothing has run on the arm yet.
    What it sends, all built, never free text: on the Dashboard port
    ResetRobot (before enabling, and in the stop), EnableRobot once,
    DisableRobot once, EmergencyStop only in the stop sequence, and five of the
    observation tool's read-only commands; on the motion port exactly two
    JointMovJ(j1,j2,j3,j4,SpeedJ=s,AccJ=s) with s at most 30 % of the
    controller's setting. protocol.py gains t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
2026-10-23 docs: MG400 jog tool, its stop sequence and what Ctrl+C does
    README of the MG400 package: a "Jog tool" section with what the tool sends
    (and what it never sends), the limits and when each is checked, the sequence
    and the arrival criterion, the stop sequence and its states, what Ctrl+C
    does in each phase (taken before the next send; ignored during the stop;
    deferred then escaping during the clean-up; the last moments that are
    Python's own), the exit codes and the record's keys, including that
    complete: true says the arm's sequence ran to the end, not that the run
    succeeded.
    Commissioning notes: §1 (the second tool and its reviewed plan), the order
    of work for the jog tool in §2 (steps 5 to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
2026-10-30 docs: MG400 jog first attempt ended at the feedback check, the arm was in alarm
    Commissioning notes §3.7: on 2026-10-30 the jog tool was started on the arm
    for the first time (controller version and speed settings typed). The first
    feedback packet showed RobotMode 9 with error_status 1, so the tool ended
    12 ms after opening the feedback port, before the Dashboard port was opened:
    no command was sent, the arm was never armed, complete: false, exit 2.
    The packets also showed joints different from every October 21 and 22
    record, so the arm had been moved since. The alarm's ID is not in the record
    (both tools end on the feedback packet before GetErrorID could go out).
    §4: the controller versi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
2026-10-30 docs: MG400 alarm codes behind the first jog attempt (67 J2 limit, 85 emergency stop)
    Commissioning notes §3.7: DobotStudio Pro's alarm panel after the run showed
    code 67 (Joint2 exceeds negative limit, consistent with the J2 reading in
    the feedback packets) and code 85 three times (hardware or software
    emergency stop). How the arm got past the limit and when the stop was
    pressed are not recorded.
    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
2026-10-30 docs: MG400 jog second run, the first complete jog record
    Commissioning notes §3.8: on 2026-10-30, after the alarms of §3.7 were
    cleared, the jog tool ran to the end on the arm (J1 +5 deg and back at
    SpeedJ = AccJ = 10 with the controller at 50 %): ResetRobot answered 0 on
    the disabled arm, EnableRobot took 1.24 s to answer and RobotMode was 5 at
    once, both JointMovJ were accepted with the full command echoed back,
    RobotMode was 7 for about 0.77 s per leg and the arrival criterion was met
    after 0.93 s, J2 / J3 stayed within 0.11 deg, DisableRobot took 1.05 s,
    the connections survived, 1122 feedback packets with no fault. Also seen
    once: a 0.10 deg J3 excursion while enabling, velocity_rati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
2026-10-30 docs: MG400 jog second run, what the operator saw
    Commissioning notes §3.8: the operator saw the arm move and return with no
    unexpected motion and no unusual sound; DobotStudio Pro showed no alarm
    afterwards.
    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
2026-10-30 docs: MG400 jog third and fourth runs, the repeat and the J4 move nobody saw
    Commissioning notes §3.9: the repeat of the J1 +5 deg run had the same
    shape and showed the once-seen items of §3.8 again (J3 excursion while
    enabling, one-packet velocity_ratio 10, J1 settling after the disable).
    §3.10: a --j1 0 --j4 5 run was reported by the controller as a 5 deg J4
    move and back (GetAngle and the feedback alike, mode 7 about 0.64 s per
    leg), while the operator at the arm saw nothing move; the J4 reading also
    changed by 1.65 deg between two runs with the arm disabled and jumped by
    1.31 deg in one feedback step after the disable. The tool's arrival
    criterion is the controller's word, so this is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
2026-10-30 docs: MG400 J4 motor is fitted; the unseen 5 deg turn is to be settled with a mark
    Commissioning notes §3.10 / §4: the operator checked the arm and the J4
    motor is fitted. A 5 deg turn of a bare flange moves its edge by about
    2 mm in 0.6 s, which may not have been visible; a run with a mark on the
    flange and a larger offset is the way to settle it. The two J4 reading
    changes with the arm disabled stay unexplained.
    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
2026-10-30 docs: MG400 jog fifth run ended on ErrorID -1 to the first RobotMode()
    Commissioning notes §3.11: with a tape mark on the flange and --j4 10, the
    feedback was normal but the first Dashboard command RobotMode() was
    answered ErrorID -1 and the tool ended before enabling, as designed. The
    first non-zero ErrorID on a read-only command in any record. The joints had
    also changed since the previous run (J4 by 80 deg), by what is not
    recorded. §4: when the controller answers -1 is open.
    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
2026-10-30 docs: MG400 ErrorID -1 persisted with DobotStudio Pro restarted and closed
    Commissioning notes §3.11 / §4: the sixth run, after DobotStudio Pro was
    restarted, disconnected and closed, got the same ErrorID -1 to the first
    RobotMode(), with the feedback normal and the joints unchanged. The -1
    does not depend on DobotStudio Pro being open; what clears it is open.
    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
2026-10-30 docs: MG400 ErrorID -1 was the remote-control mode; J4 +10 deg seen to turn
    Commissioning notes §3.11: the operator found DobotStudio Pro's remote-control
    mode was no longer TCP/IP; set back, the next run went through, so ErrorID -1
    to a read-only query is what the controller answers when TCP/IP remote
    control is off (the feedback port streams regardless). The second record in
    the same --out folder overwrote the first: a new folder name per run (§4).
    §3.12: --j1 0 --j4 10 ran to the end and the tape mark on the flange was
    seen to turn; the J4 reading again changed about 1 deg with the arm
    disabled (between runs and right after the disable), unexplained (§4).
    §2 step 6 and the package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
2026-10-30 mg400: the jog tool refuses a --out folder that already holds files
    On 2026-10-30 four bench records were lost because the tool wrote into a
    reused --out folder without a warning (two complete jog records among
    them). The CLI now checks the folder before anything is opened: a folder
    that holds files, or one that cannot be listed, ends the run with exit 2
    and nothing reaches the arm. The default folder carries the UTC time and is
    unaffected; an empty existing folder is still accepted (the tests' tmp_path).
    Not guarded: two runs started into the same empty folder at once (the
    README says so). The observation tool is unchanged.
    Three tests: a folder with a file is refused and left untouched,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
2026-10-30 docs: MG400 bench of 2026-10-30 reconciled with the records after review
    Astra's review of the bench write-up found that three of the six record
    folders had been overwritten by later invocations that reused --out:
    the complete runs of §3.8 (J1 +5 deg) and §3.10 (J4 +5 deg) and two of
    the ErrorID -1 runs. Commissioning notes now say which records survive on
    disk, which numbers come from reads made before the overwrite (kept
    verbatim in a text file next to the records), and list the five -1
    invocations with their times, folders, reply times and packet counts.
    Corrections from the review: Enter-to-arm 5.9 s (not 6.6); the
    velocity_ratio 10 packet is the last mode-5 or first mode-7 packet of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
2026-10-30 mg400: extract control.py from the jog tool (flow plan stage one, behaviour unchanged)
    The connection, enable / disable, stop sequence, background I/O, record and
    clean-up code of jog.py moves to src/devices/mg400/control.py so that the
    planned robot wrapper (type: mg400) can share it. jog.py keeps the CLI, the
    preconditions, the SIGINT handler and jog() itself, and imports the rest
    back. The core takes the owner's interrupt object; without one a
    _NoInterrupts that never raises stands in.
    Regression: the 171 jog tests and the observation tests pass (31 patches
    retargeted to jog.control; the motion-port guard test now allows
    control.py to name the port); the 99-entry mutation harness, with i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
2026-10-31 docs: roadmap v3 and v3.1 (send/stop exclusion C6, abnormal-end contract, counterexample table; weighing and dispensing contract C7 with Phase 2W)
    v3 reflects the five points of the Astra re-review of v2. v3.1 adds the
    balance and pipette inconsistencies found in the src/ analysis: the
    accuracy logger's cumulative-weight error, the weight median, the scale
    unit, forwarding of wait settings, pipette presence and the LLM example.
2026-10-31 docs: roadmap v4 after the Astra review of v3 (send/stop/resume state machine in C6, move_slider in 1a(9), Picus2 worker and connection lifetime, per-case 0-1 expectations, non-zero exit for CI skips)
2026-10-31 test: counterexamples to the workspace and rejection guarantees (roadmap 0-1)
    Nine cases from the roadmap's 0-1 table, run on the real wrapper (LabRobot
    over PyDobotController with a fake pydobot device that records every
    state-changing command) and on MockLabRobot. Pairs that do not hold today
    are strict xfails, to be turned into passes by items 1a and C1.
2026-11-02 cad: replace the Picus 2 holder with short, middle, tall and 3_middle variants
    Add four variants under cad/pipette-holder/picus2/, each with .stl, .f3d and
    .step, and remove the single picus2_holder.{stl,f3d}. Its 135 mm mesh is kept
    as picus2_holder_middle.
    short is T. Muramoto's original; middle, tall and 3_middle are Y. Hashimoto's
    derivatives. Update the previews, gallery, designer and component tables, and
    note that changing variant shifts the pipette tip, so the cell must be
    re-measured and the flow coordinates and workspace limits revised.
2026-11-02 docs(cad): group the gallery by component type
    Split the gallery into robot-arm pedestal, pipette holders, balance cover and
    vessel adapters, vessel holder, and imaging stand. Move the assembled vessel
    holder into its table so that it lines up with the other pictures.
2026-11-03 docs(cad): credit the vessel holder to Y. Hashimoto
    The base and upper frame of the 500 mL vessel holder had no designer in
    the Components table and were missing from the Designers table, so the
    attribution that the CC BY notice asks for could not be given in full.
2026-11-04 mg400: robot type mg400 for flows (flow plan stage two)
    A config.yaml entry with type: mg400 (optional robot 5) makes the Dobot MG400 a
    SAIGEN robot: move_xyz, move_z, go_home and wait only, every move one MovL
    (User=0, Tool=0, SpeedL = AccL = speed_ratio <= 10) after six validation steps on
    the measured start pose (own box, radius, minimum and maximum length, analytic
    segment radius, InverseSolution samples within joint_limits).
    - control.Controller: one non-daemon worker owns the command connections; one
    stop latch taken at every send, reply and 0.1 s wake-up; the jog tool's stop
    sequence runs on the worker; shutdown is one worker request; cancellation-safe
    futures; a failed final r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
2026-11-04 docs: MG400 as a flow robot type (setup §13, commissioning C1-D, Ctrl+C in a flow)
    - docs/setup.md §13: configuration keys (all required, nothing inherited, value
    ranges), the real run's Enter, stopping (first Ctrl+C through a separate thread,
    later ones deferred, the disconnect bound and what to do when a step is stuck
    elsewhere), records.
    - docs/mg400-commissioning.md: bench stages C1 to D in §2, Ctrl+C in a flow in §5.
    - docs/experimental-flow.md, README.md, src/devices/mg400/README.md: the robot
    type, its actions and its stop.
    - CLAUDE.md = AGENTS.md: the MG400 row, examples/mg400, rule 1 for flows on the
    MG400, the "Use the MG400" task.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
2026-11-04 mg400: record a CI false feedback fault; mock-run tests report the MG400 record on failure
    The first CI run of 88443be failed once on Python 3.12: a mock flow run ended in
    an autonomous stop because the feedback watcher judged a RobotMode 7 packet
    after the moving phase's 0.3 s grace (stop sequence reset_disable, run marked
    failed). The fake's Dashboard and feedback read the same mode, so the likely
    cause is a delivery lag of the reader on a busy runner. The rerun of the same
    commit passed on 3.11 and 3.12; not reproduced locally under CPU load.
    - tests/test_mg400_wiring.py: mock_main() puts the MG400 record (phases, stop,
    feedback, notes) into the assertion when a mock run's exit code is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
2026-11-04 docs: MG400 stage C1 first attempt (Ctrl+C after the legs; J2 2 deg below target while enabled)
    jog_07 of 2026-11-04: the stop sequence ran on the arm from rest (ResetRobot,
    DisableRobot answered on a stop connection after the first connection gave no
    reply within 1 s, RobotMode 4 held: reset_disable, disabled), but the Ctrl+C
    came 0.41 s after the leg back had arrived, so C1's stop during motion is not
    met (a 5 deg leg lasts about 0.9 s at the defaults).
    The feedback shows J2's q_actual 2.06 deg below q_target from the Enable on,
    for about 5 s, without an alarm, while GetAngle() answered the target. The same
    start in jog_06 showed 0.07 deg. Open points: the cause, and that the flow
    robot t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
2026-11-04 docs: MG400 stage C1 second attempt (stop during the leg back, reset_disable)
    jog_08: --j1 10 --speed 3; Ctrl+C during the leg back, J1 stopped about
    0.8 deg after the trigger within 0.12 s, RobotMode 4 at 0.73 s; DisableRobot
    on the first connection again without a reply within 1 s (the arm was
    disabled 0.56 s after the send); J2 did not sink at the new start; the
    operator saw slight sinking at the stop, the feedback shows 0.03 mm in z
    after the disable.
    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
2026-11-04 docs: MG400 stage C1 accepted by the operator; the sinking seen at the stop
    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
2026-11-04 mg400: check the measured joints against the target at rest (tracking)
    Stage C1's first attempt showed J2's q_actual 2 deg below q_target while
    enabled, with GetAngle answering the target. The flow robot type now
    compares the feedback's q_actual with q_target and with the GetAngle()
    value about to be used, after the Enable, at every enabled pose read,
    before every MovL and at arrival (under the move's deadline; a mismatch
    there is a retry), and with the target only between requests. Only a
    packet with RobotMode 5 received strictly after the check began counts;
    every copy is judged fail-closed. More than 0.2 deg stops the run.
    Every check inside a step and every failing exit is recorded.
    Co-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
2026-11-04 docs: MG400 joint tracking check (setup §13, commissioning C2, README, agent row)
    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
2026-11-10 mg400: a fitted planar model for the fake, chosen by shared_devices.mock_kinematics
    The fake's stand-in model cannot place a real rest pose near the base, so
    --mock failed with a measured configuration. FakeMG400 now takes
    kinematics="standin" (default, unchanged) or "fitted_planar_v1", a planar
    approximation fitted to one controller's PositiveSolution answers at 13
    joint sets. Only the mock reads the selection; a written value that is
    null, not a mapping, not a string or unknown is a ConfigError, and the
    model used is written into the run's MG400 record.
    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
